NicolasNobili/MARK-1/README.md

# MARK I

## Multi Angle Radar Kinematics Mk. 1

# [Interfaz](https://nicolasnobili.github.io/MARK-1/)

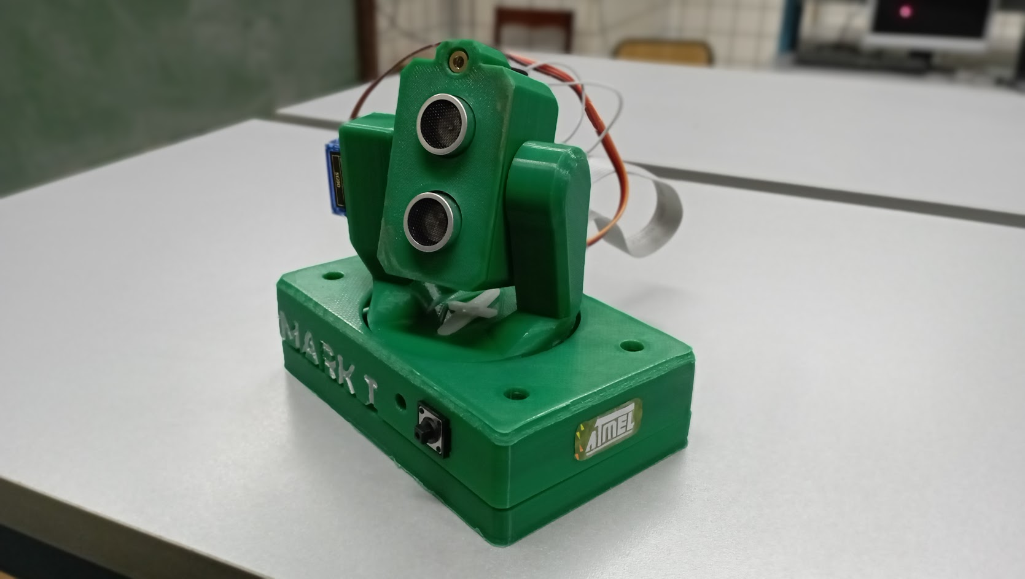
[picture p1: foto.png]
Foto
#
