NicolasNobili/MARK-1/markinforme/flujo.drawio.png

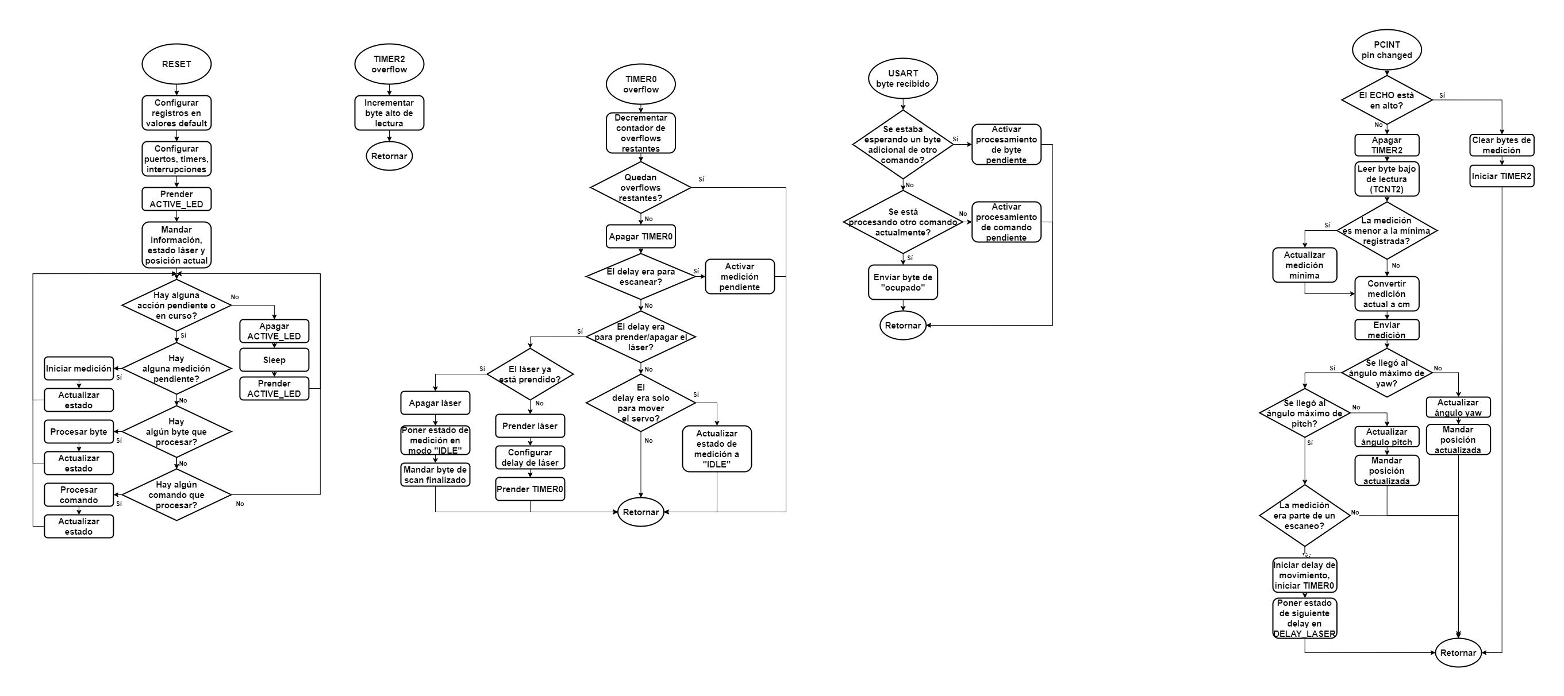
markinforme/flujo.drawio.png
