NicolasNobili/MARK-1/markinforme/flujo_timer2.png

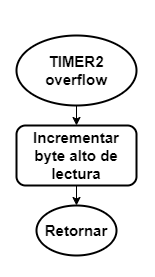
markinforme/flujo_timer2.png
