NicolasNobili/MARK-1/markmodel/3d_models/608rs-skate-bearing (1)/Renderings/608RS20111010-29232-tabqn5.JPG

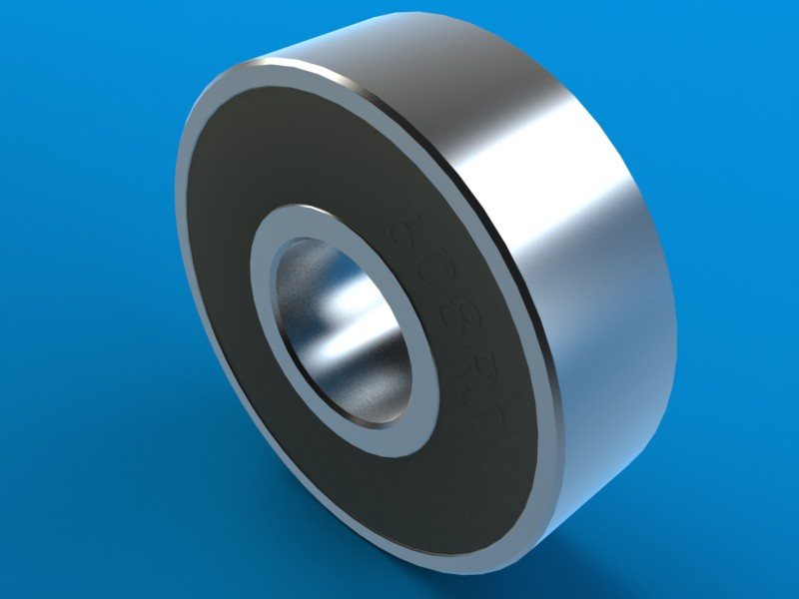
markmodel/3d_models/608rs-skate-bearing (1)/Renderings/608RS20111010-29232-tabqn5.JPG
