NicolasNobili/MARK-1/markmodel/3d_models/608rs-skate-bearing (1)/608RS.SLDPRT

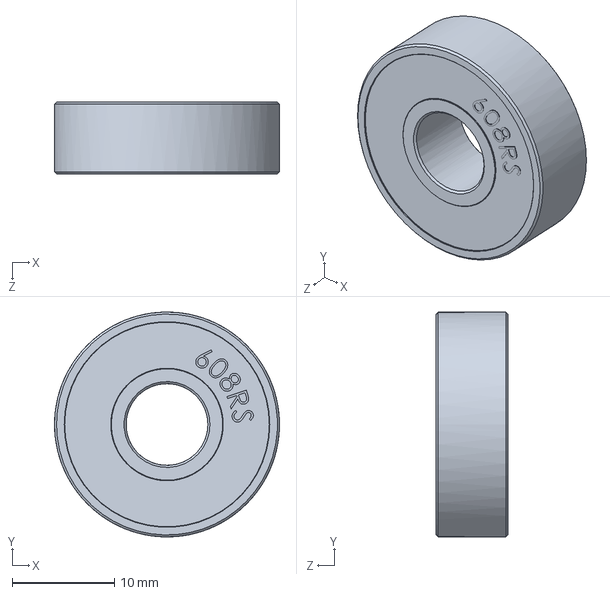
[picture p18: CAD file, 2023-11-22]
markmodel/3d_models/608rs-skate-bearing (1)/608RS.SLDPRT
22.0 x 22.0 x 7.00 mm
