NicolasNobili/MARK-1/markmodel/3d_models/DC_Power_Jack_PCB_Mounted_2.1mm.step

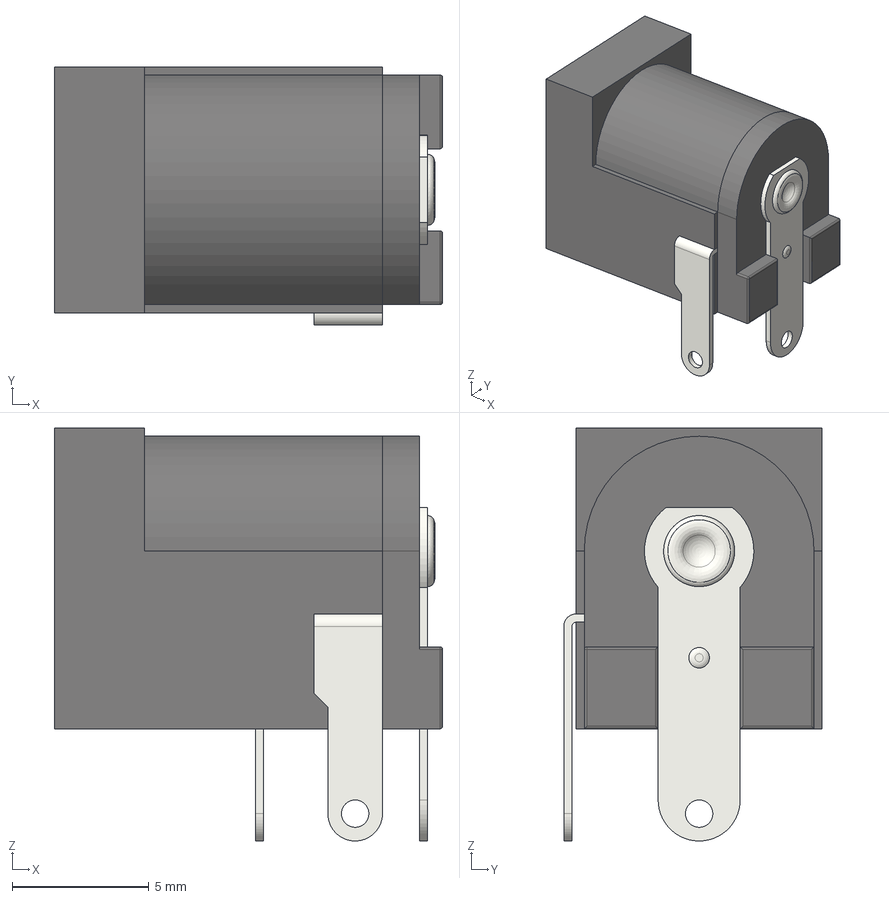
[picture p19: CAD file, 2023-11-27]
markmodel/3d_models/DC_Power_Jack_PCB_Mounted_2.1mm.step
14.2 x 9.45 x 15.1 mm
Plastic_Body_1of2
Plastic_Body_2of2
PIN_01
PIN_03
PIN_02
Boner
