NicolasNobili/MARK-1/markmodel/3d_models/hc-sr04-ultrasonic-sensor-8.snapshot.15/hc-sr04.SLDPRT

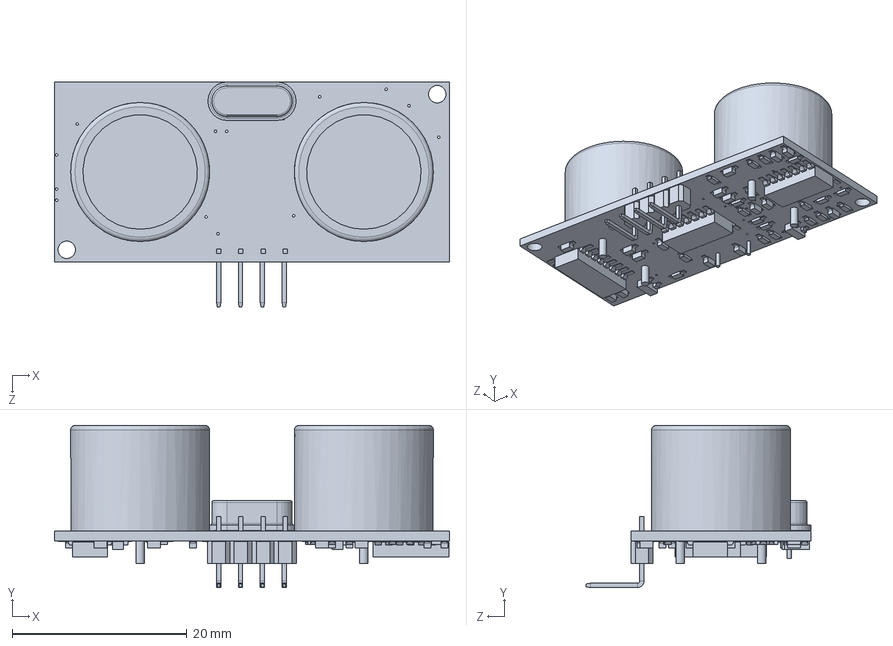
[picture p20: CAD file, 2023-11-12]
markmodel/3d_models/hc-sr04-ultrasonic-sensor-8.snapshot.15/hc-sr04.SLDPRT
45.2 x 18.5 x 25.8 mm
