NicolasNobili/MARK-1/markmodel/3d_models/sg90-micro-servo-9g-tower-pro-1.snapshot.3/SG90 - Micro Servo 9g - Tower Pro.2.SLDPRT

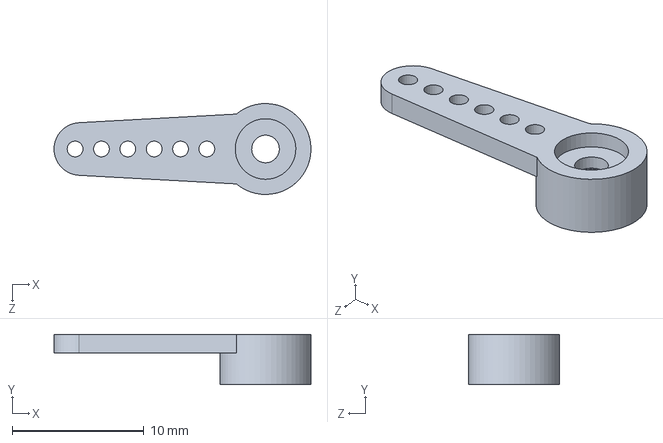
[picture p21: CAD file, 2023-11-22]
markmodel/3d_models/sg90-micro-servo-9g-tower-pro-1.snapshot.3/SG90 - Micro Servo 9g - Tower Pro.2.SLDPRT
19.5 x 3.80 x 6.90 mm
