NicolasNobili/MARK-1/markmodel/cutemark.FCStd

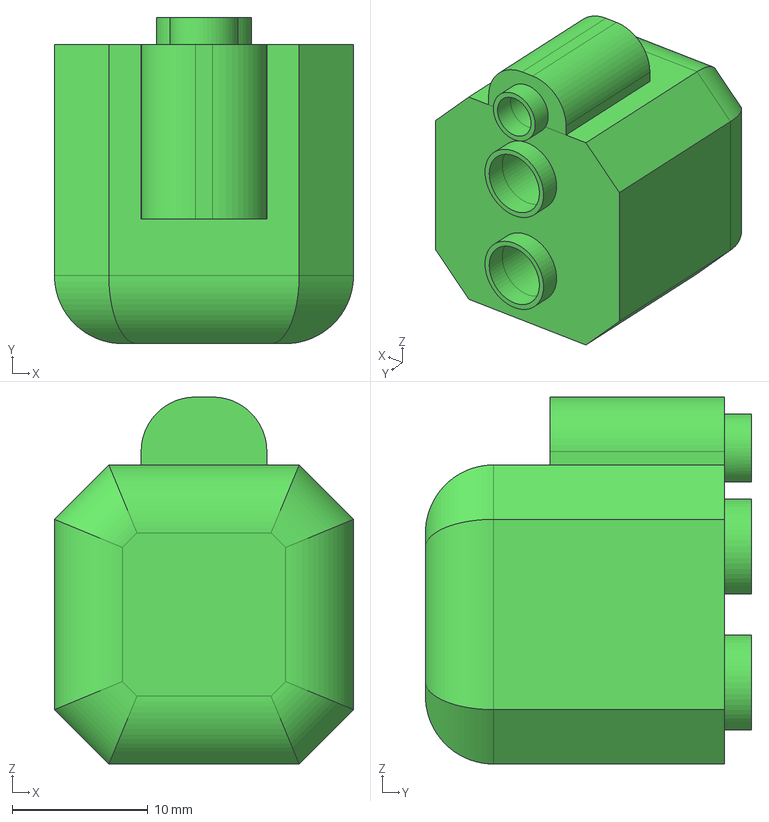
[picture p22: CAD file, 2023-12-03]
markmodel/cutemark.FCStd
22.0 x 24.0 x 27.0 mm
