NicolasNobili/MARK-1/markmodel/stl_files/gabinete_top-v3.stl

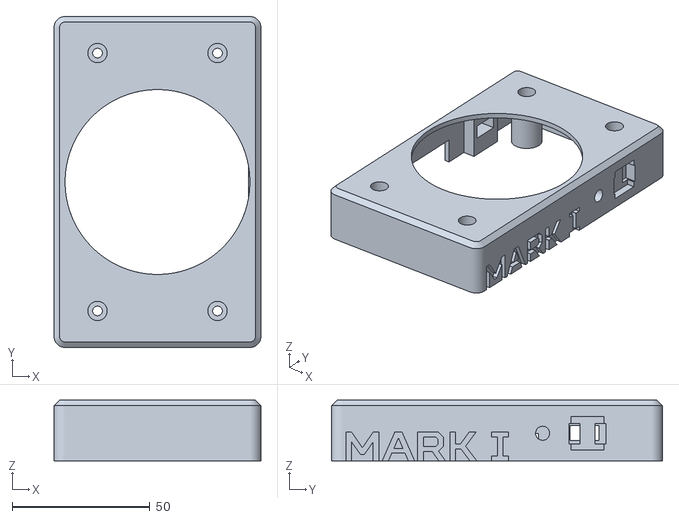
[picture p23: CAD file, 2023-12-02]
markmodel/stl_files/gabinete_top-v3.stl
75.0 x 120.0 x 22.0
