NicolasNobili/MARK-1/markmodel/3d_models/sg90-micro-servo-9g-tower-pro-1.snapshot.3/SG90 - Micro Servo 9g - Tower Pro.6.SLDPRT

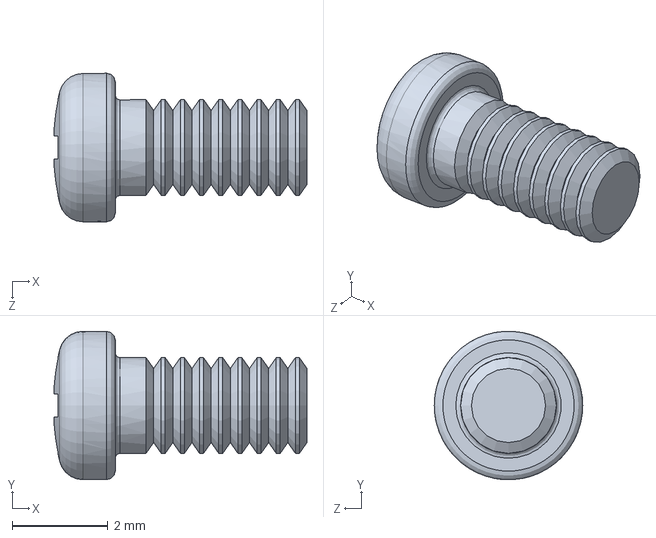
[picture p24: CAD file, 2023-11-22]
markmodel/3d_models/sg90-micro-servo-9g-tower-pro-1.snapshot.3/SG90 - Micro Servo 9g - Tower Pro.6.SLDPRT
5.28 x 3.10 x 3.10 mm
