NicolasNobili/MARK-1/markmodel/3d_models/ToggleSwitch_3Pin.step

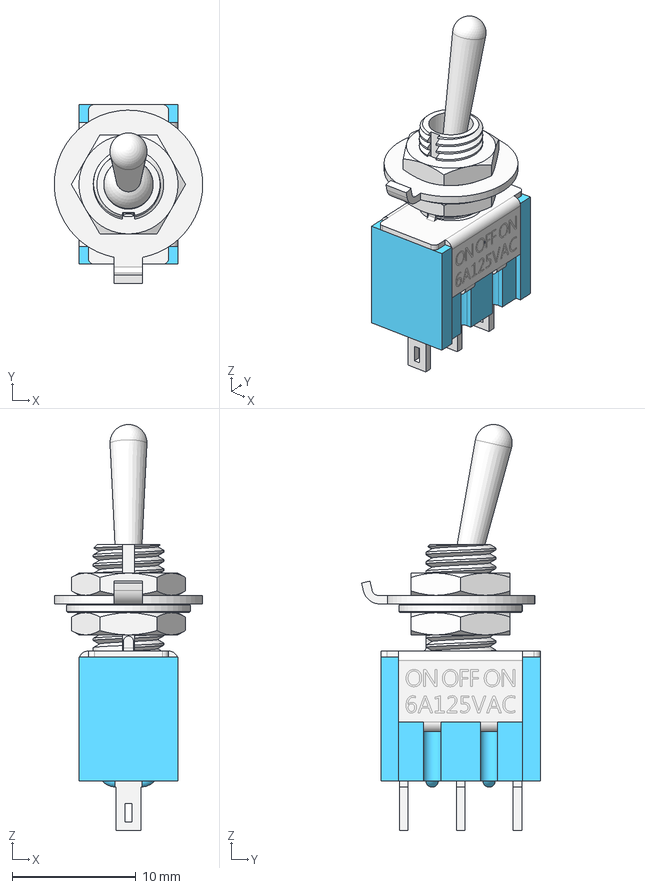
[picture p25: CAD file, 2023-11-26]
markmodel/3d_models/ToggleSwitch_3Pin.step
12.0 x 14.4 x 32.8 mm
Washer Anti Twist Protection
Nut M6x0.75mm
Nut M6x0.75mm clone
Sheetmatal Frame
Plastic Body
Thread
Batton Clone 1
PIN_1of3
PIN_2of3
PIN_3of3
Washer
