NicolasNobili/MARK-1/markmodel/encastre-servo.FCStd

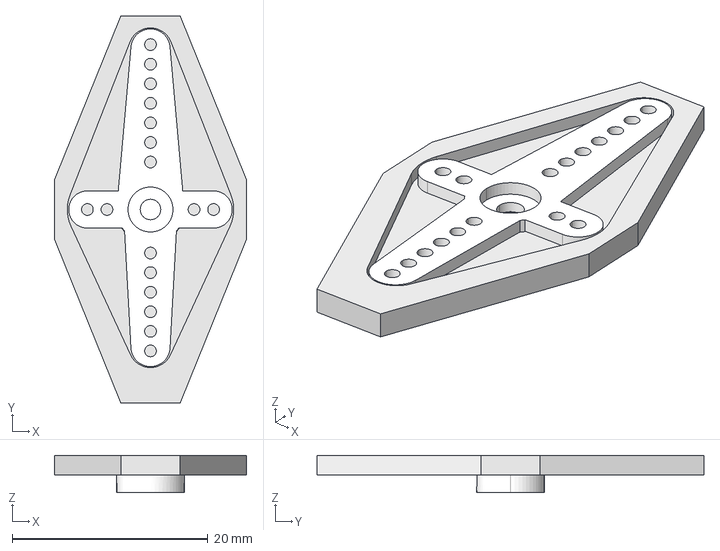
[picture p26: CAD file, 2023-11-25]
markmodel/encastre-servo.FCStd
19.7 x 39.5 x 3.80 mm
SG90 - Micro Servo 9g - Tower Pro.4_Pea
