NicolasNobili/MARK-1/markmodel/stl_files/gabinete_bottom-v2.stl

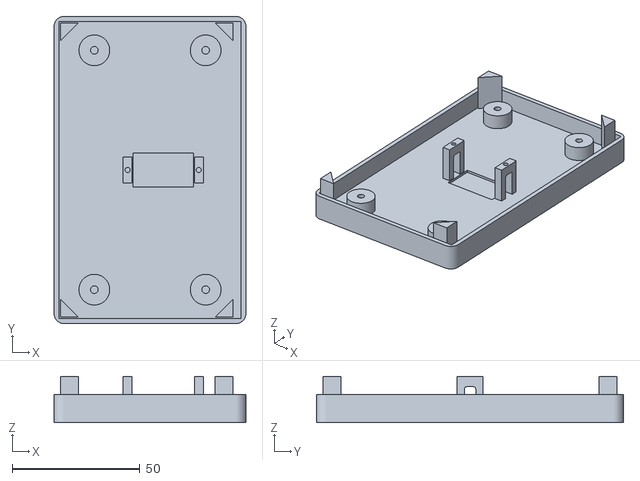
[picture p27: CAD file, 2023-11-30]
markmodel/stl_files/gabinete_bottom-v2.stl
75.0 x 120.0 x 18.0
