NicolasNobili/MARK-1/markmodel/3d_models/HC-06_Bluetooth_Module.step

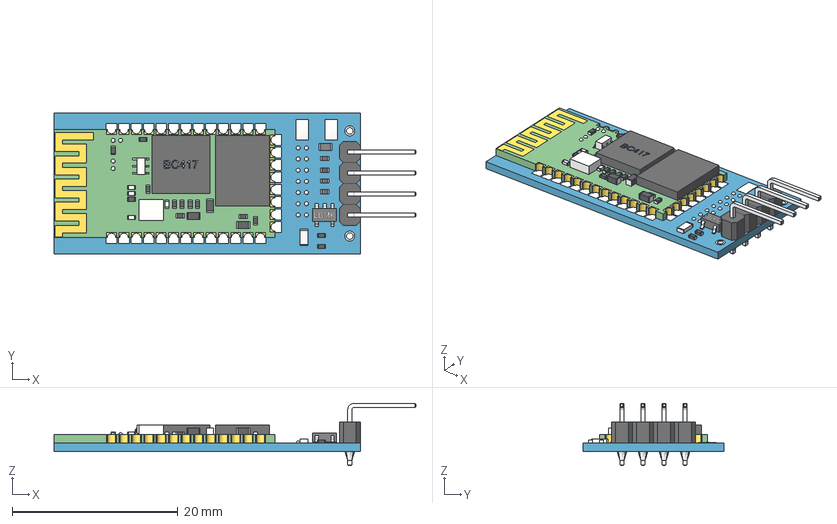
[picture p28: CAD file, 2023-11-23]
markmodel/3d_models/HC-06_Bluetooth_Module.step
43.7 x 17.0 x 7.52 mm
board
SPP-C_Bluetooth_Module
BC417
mx
small1005_smd_capacitor x 10
smd_capacitor x 3
small1005_smd_resistor
small_smd_led x 4
16MHz_Resonator_1
SOP-6
solder_dot_round_small x 4
smd_led
smd1005_smd_capacitor x 3
5V_regulator
solder_dot_round_small (1) x 14
solder_rectangle x 2
smd1005_resistor x 3
smd1608_resistor
pin_header_90_degree_bend x 4
solder x 4
