NicolasNobili/MARK-1/markmodel/columna_servo.FCStd

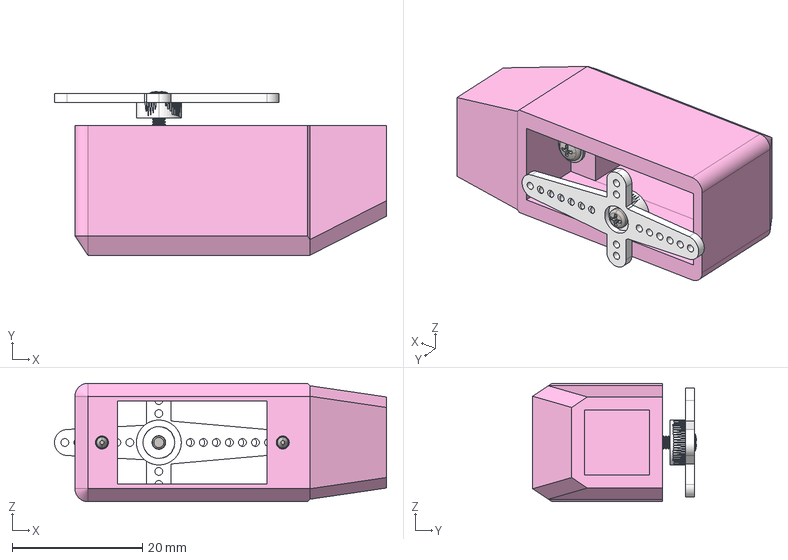
[picture p29: CAD file, 2023-11-23]
markmodel/columna_servo.FCStd
51.0 x 25.2 x 18.2 mm
columna_servo
SG90 - Micro Servo 9g - Tower Pro.2_Pea
SG90 - Micro Servo 9g - Tower Pro.3_Pea
SG90 - Micro Servo 9g - Tower Pro.4_Pea
SG90 - Micro Servo 9g - Tower Pro.5_BS EN ISO 7045 - M2 x 8 - Z - 8S
SG90 - Micro Servo 9g - Tower Pro.5_BS EN ISO 7045 - M2 x 8 - Z - 8S001
SG90 - Micro Servo 9g - Tower Pro.6_BS EN ISO 7045 - M2 x 4 - Z - 4S
