NicolasNobili/MARK-1/markmodel/stl_files/mark_tapa-v6.stl

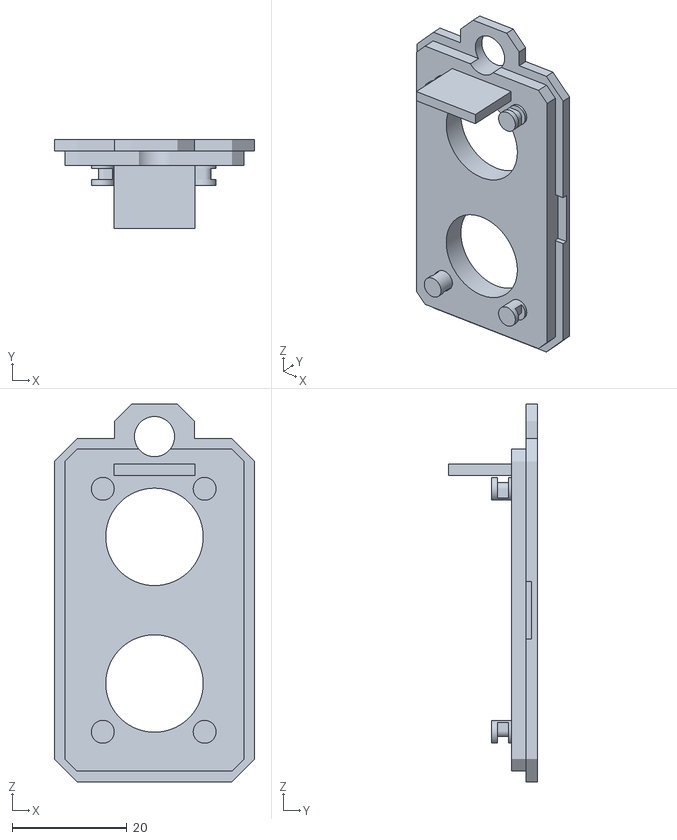
[picture p30: CAD file, 2023-11-30]
markmodel/stl_files/mark_tapa-v6.stl
35.0 x 15.5 x 66.0
