NicolasNobili/MARK-1/markmodel/3d_models/LaserModule.stp

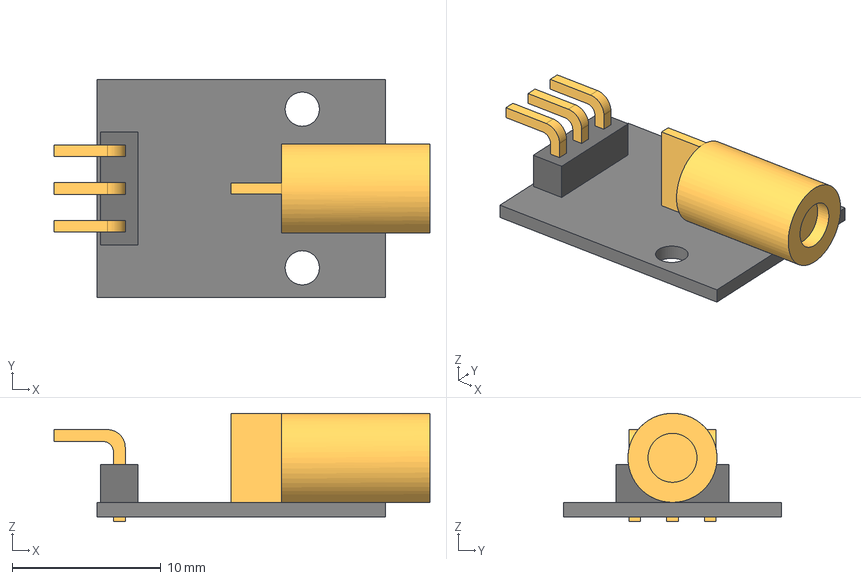
[picture p31: CAD file, 2023-11-13]
markmodel/3d_models/LaserModule.stp
25.3 x 14.7 x 7.30 mm
