NicolasNobili/MARK-1/markmodel/columna_ruleman.FCStd

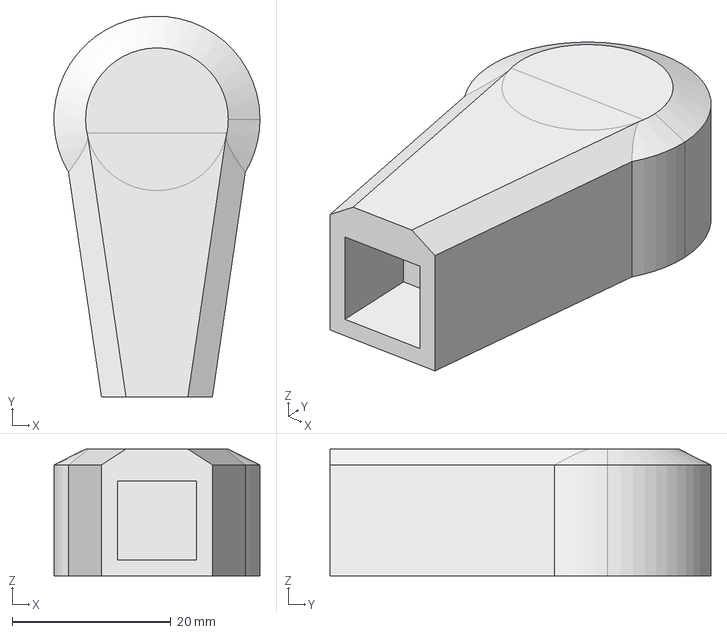
[picture p33: CAD file, 2023-11-23]
markmodel/columna_ruleman.FCStd
26.0 x 48.0 x 16.0 mm
