NicolasNobili/MARK-1/markmodel/mark3D.FCStd

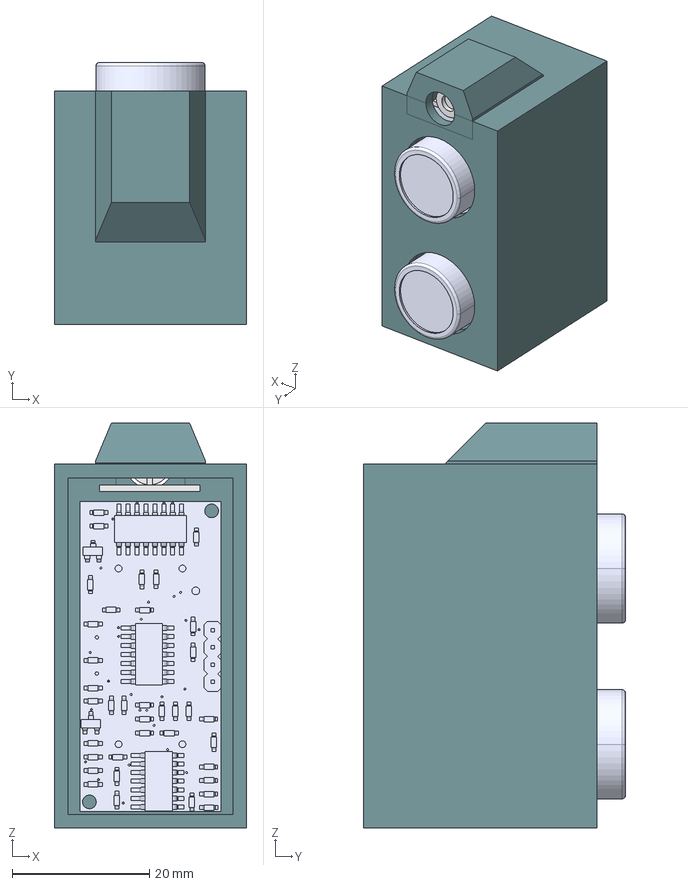
[picture p35: CAD file, 2023-11-14]
markmodel/mark3D.FCStd
28.0 x 38.2 x 59.0 mm
HC-SR04
Laser (truncado)
