NicolasNobili/MARK-1/markmodel/mark3D-gabinete-borrador1.stl

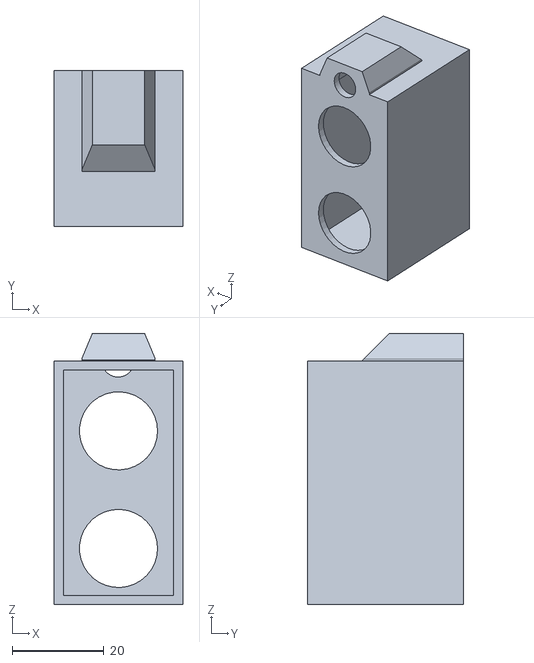
[picture p37: CAD file, 2023-11-14]
markmodel/mark3D-gabinete-borrador1.stl
28.0 x 34.0 x 59.0
