NicolasNobili/MARK-1/markmodel/stl_files/base_rotativa-v3.stl

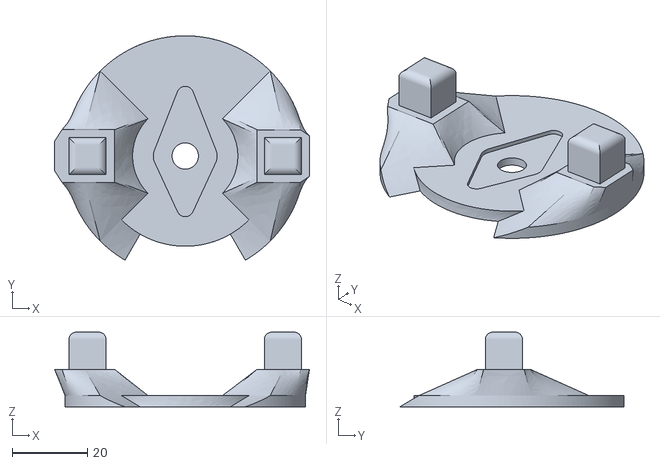
[picture p39: CAD file, 2023-11-24]
markmodel/stl_files/base_rotativa-v3.stl
67.9 x 59.7 x 19.9
