NicolasNobili/MARK-1/markmodel/stl_files/encastre_servo-v1.stl

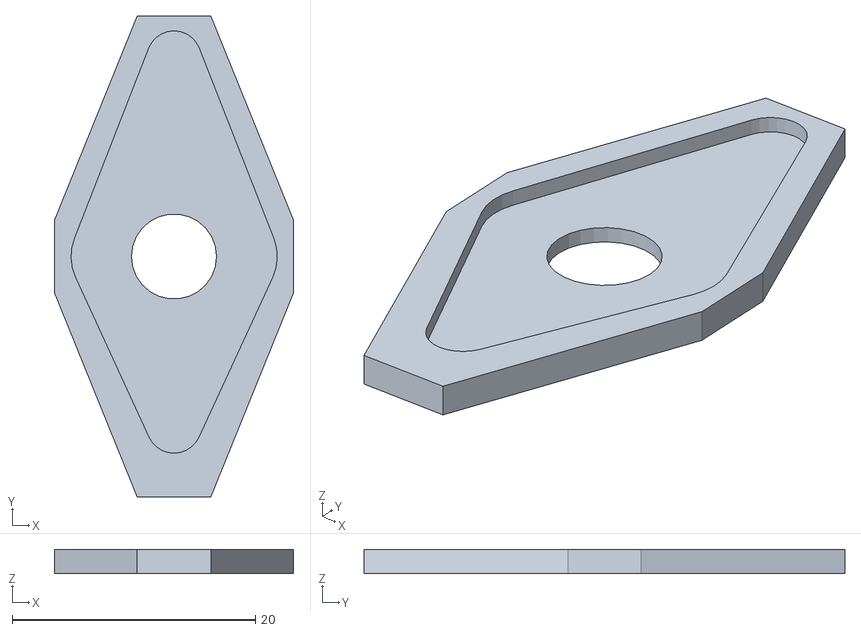
[picture p40: CAD file, 2023-11-24]
markmodel/stl_files/encastre_servo-v1.stl
19.7 x 39.5 x 2.00
