NicolasNobili/MARK-1/markmodel/stl_files/columna_servo-v2.stl

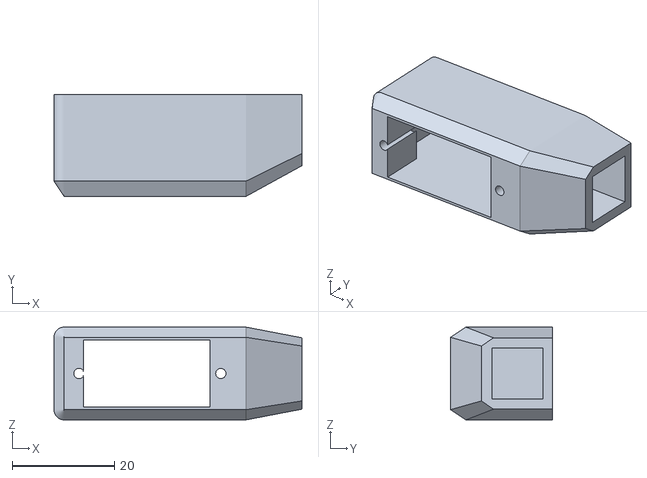
[picture p41: CAD file, 2023-11-24]
markmodel/stl_files/columna_servo-v2.stl
48.6 x 20.0 x 18.2
