NicolasNobili/MARK-1/markmodel/stl_files/mark_body-v1.stl

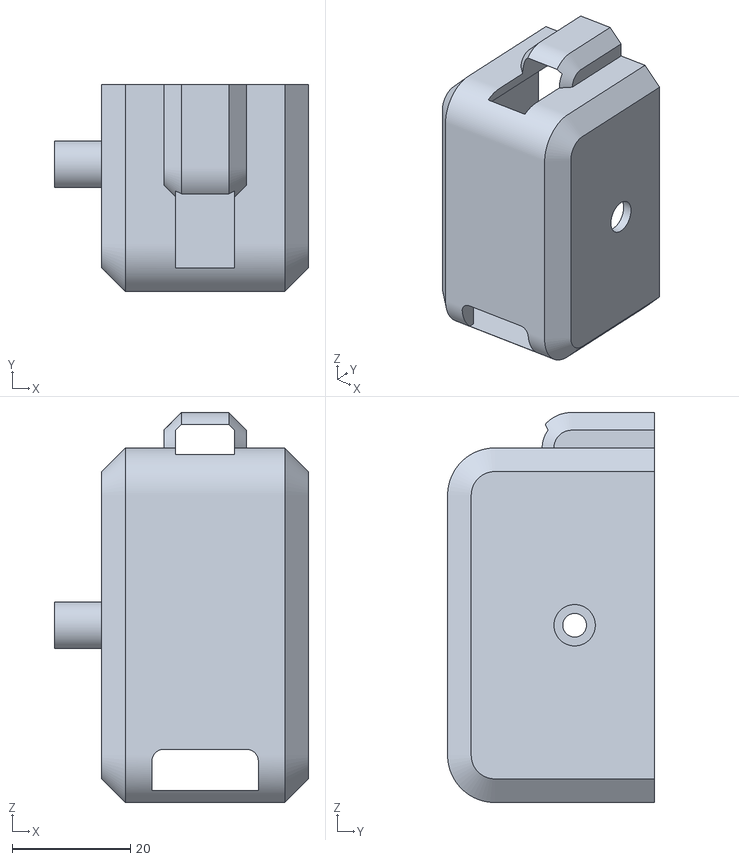
[picture p42: CAD file, 2023-11-24]
markmodel/stl_files/mark_body-v1.stl
43.0 x 35.0 x 66.0
