NicolasNobili/MARK-1/(list of files, cad)

Other CAD files:
markmodel/stl_files/columna_ruleman-v1.stl
markmodel/3d_models/608rs-skate-bearing (1)/608RS.stl
markmodel/3d_models/sg90-micro-servo-9g-tower-pro-1.snapshot.3/SG90 - Micro Servo 9g - Tower Pro.x_t
markmodel/stl_files/base_rotativa-v1.stl
markmodel/stl_files/base_rotativa-v2.stl
markmodel/stl_files/columna_servo-v1.stl
markmodel/stl_files/gabinete_bottom-v1.stl
markmodel/stl_files/gabinete_top-v1.stl
markmodel/stl_files/gabinete_top-v2.stl
markmodel/stl_files/mark_tapa-v1.stl
markmodel/stl_files/mark_tapa-v3.stl
markmodel/stl_files/mark_tapa-v4.stl
markmodel/stl_files/mark_tapa-v5.stl
