NicolasNobili/MARK-1/markmodel/markcircuit/schematic.pdf

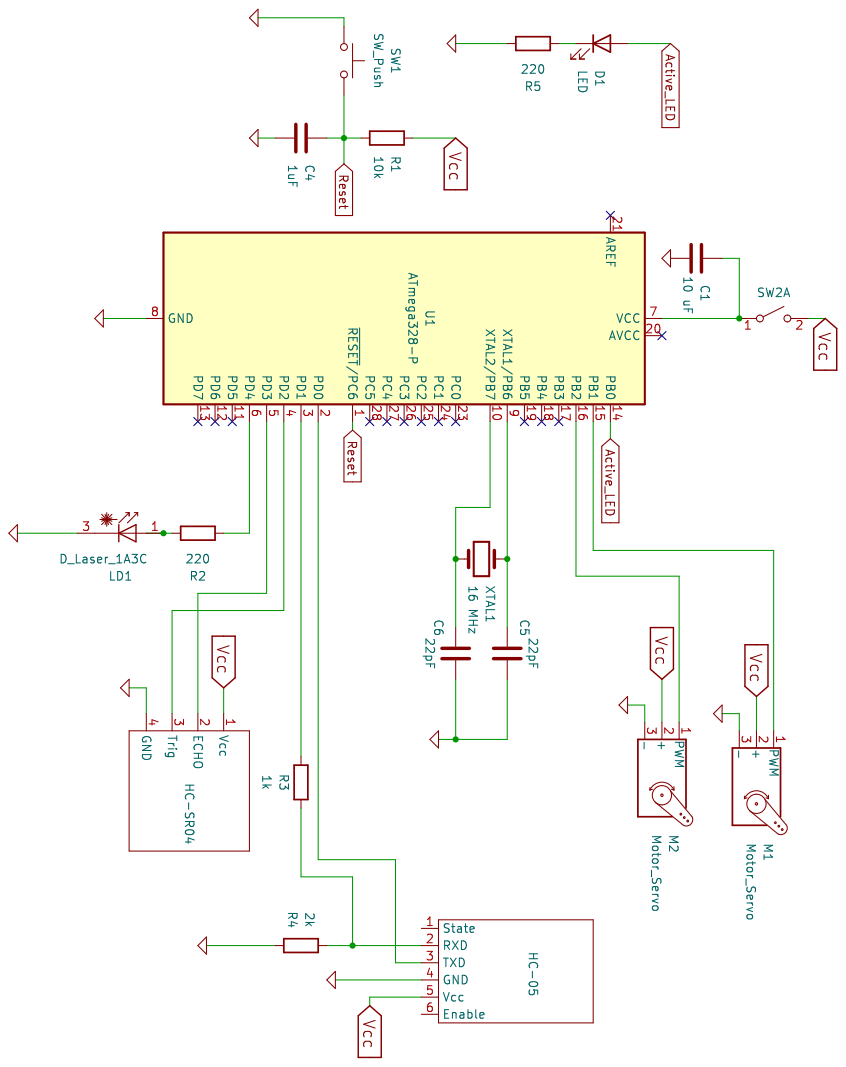
[picture p43: page 1]
