NicolasNobili/MARK-1/(list of files, drawings)

Other design files:
TI_Nobili_Russo_proteus.pdsprj
