NicolasNobili/MARK-1/markmodel/markcircuit/markcircuit.kicad_pcb

## KiCad design schmatic/schmatic.kicad_sch

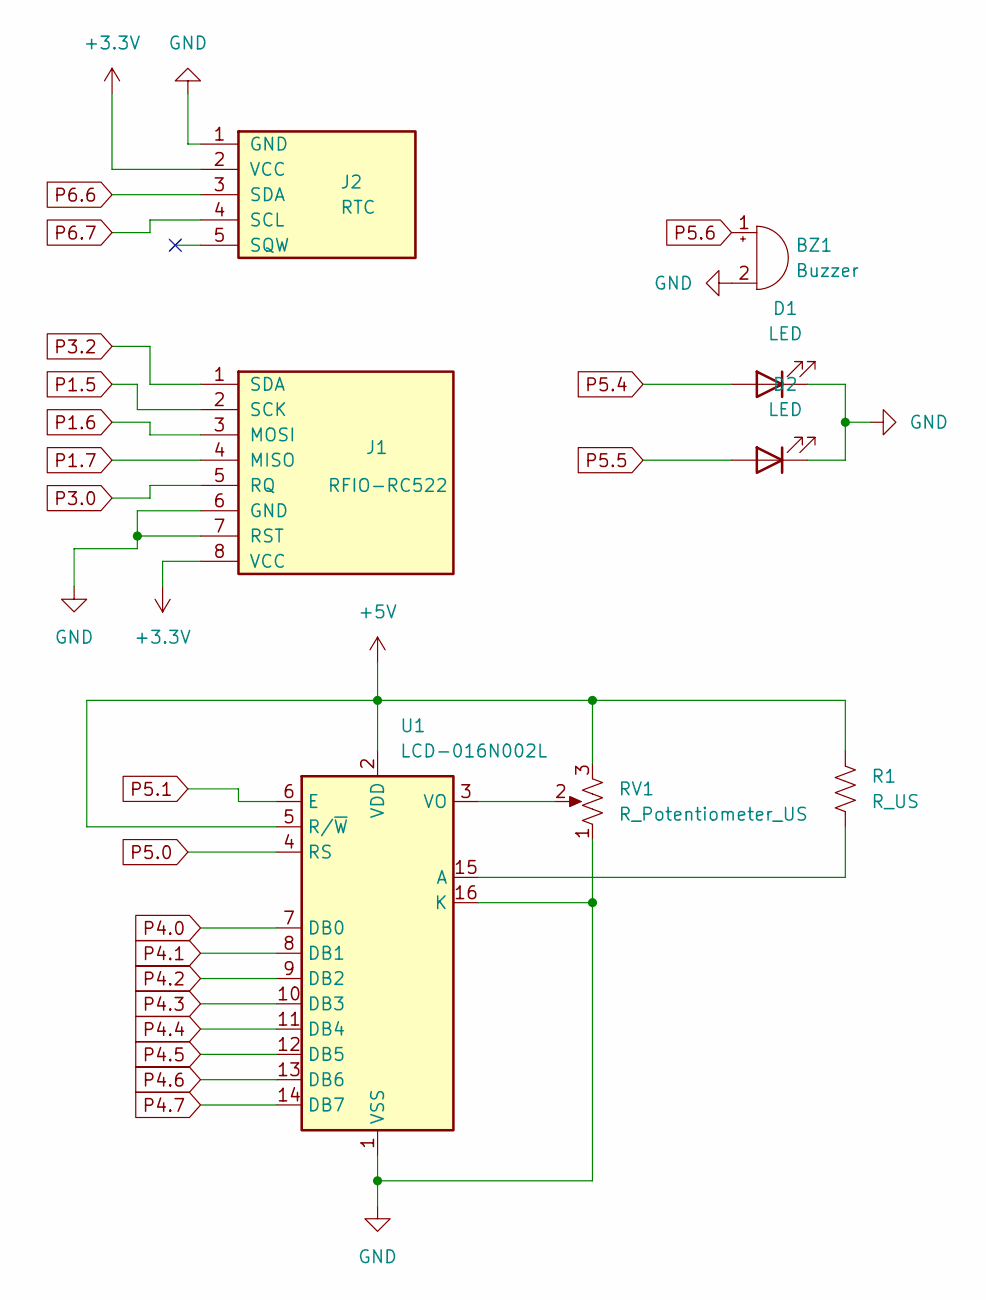
[picture p44: schematic schmatic.kicad_sch]

Parts:
BZ1: Buzzer
D1, D2: LED
J1: RFIO-RC522
J2: RTC
R1: R_US
RV1: R_Potentiometer_US
U1: LCD-016N002L

Connections:
+3.3V: J1.8 (VCC), J2.2 (VCC)
+5V: R1.1, RV1.3, U1.2 (VDD), U1.5 (R/~W)
GND: BZ1.2 (-), D1.1 (K), D2.1 (K), J1.6 (GND), J1.7 (RST), J2.1 (GND), RV1.1, U1.1 (VSS), U1.16 (K)
unnamed: R1.2, U1.15 (A)
unnamed: RV1.2, U1.3 (VO)
P1.5: J1.2 (SCK)
P1.6: J1.3 (MOSI)
P1.7: J1.4 (MISO)
P3.0: J1.5 (RQ)
P3.2: J1.1 (SDA)
P4.0: U1.7 (DB0)
P4.1: U1.8 (DB1)
P4.2: U1.9 (DB2)
P4.3: U1.10 (DB3)
P4.4: U1.11 (DB4)
P4.5: U1.12 (DB5)
P4.6: U1.13 (DB6)
P4.7: U1.14 (DB7)
P5.0: U1.4 (RS)
P5.1: U1.6 (E)
P5.4: D1.2 (A)
P5.5: D2.2 (A)
P5.6: BZ1.1 (+)
P6.6: J2.3 (SDA)
P6.7: J2.4 (SCL)
