NicolasNobili/MARK-1/(commit log)

2023-11-11 Nace MARK-1
    [usart_prueba.pdsprj]
2023-11-11 elimino archvios basura
    [usart_prueba.pdsprj]
2023-11-12 carriage return new line
2023-11-12 problemas al medir
    [MARK1_proteus.pdsprj]
2023-11-12 pudimos medir algo
    [MARK1_proteus.pdsprj]
2023-11-12 modelado 3d y circuito
    [MARK1_proteus.pdsprj, hc-sr04.SLDPRT, mark3D.FCStd, markcircuit.kicad_pcb, markcircuit.kicad_sch]
2023-11-13 reorganizacion de codigo
2023-11-13 disenio 3D basico
    [LaserModule.stp, MARK1_proteus.pdsprj, mark3D.FCStd]
2023-11-14 power down
2023-11-14 active led
2023-11-15 mark beta
    [MARK1_proteus.pdsprj]
2023-11-15 sleep + reset + change position fixed
    [MARK1_config.asm, MARK1_handlers.asm, MARK1_include.asm, main.asm]
2023-11-22 3d model
    [608RS.SLDPRT, 608RS.stl, MARK1_proteus.pdsprj, SG90 - Micro Servo 9g - Tower Pro.1.SLDPRT, SG90 - Micro Servo 9g - Tower Pro.2.SLDPRT, SG90 - Micro Servo 9g - Tower Pro.3.SLDPRT, SG90 - Micro Servo 9g - Tower Pro.4.SLDPRT, SG90 - Micro Servo 9g - Tower Pro.5.SLDPRT]
2023-11-22 encastre ruleman
    [columna_ruleman.FCStd]
2023-11-22 update tamaño ruleman
    [columna_ruleman.FCStd]
2023-11-22 columna servo (sin medidas)
    [columna_servo.FCStd]
2023-11-23 parte ruleman terminado (?)
    [columna_ruleman.FCStd]
2023-11-23 modelo stl ruleman
    [columna_ruleman-Body001.stl, columna_ruleman.FCStd]
2023-11-23 columnas ruleman servo stls
    [columna_ruleman-Body001.stl, columna_ruleman-v1.stl, columna_ruleman.FCStd, columna_servo-v1.stl, columna_servo.FCStd]
2023-11-23 todo en el archivo MARK3D
    [HC-06_Bluetooth_Module.step, columna_ruleman.FCStd, columna_servo.FCStd]
2023-11-24 details 3D model
    [columna_ruleman-v1 - Copy.stl]
2023-11-24 stl folder
    [base_rotativa-v1.stl, columna_ruleman-v1 - Copy.stl, columna_ruleman-v1.stl, columna_servo-v1.stl, columna_servo.stl, mark_body-v1.stl, mark_tapa-v1.stl]
2023-11-24 versiones nuevas
    [mark_tapa-v3.stl]
2023-11-25 qierido mark
    [encastre-servo.FCStd]
2023-11-25 Schematic + symbols
    [markcircuit.kicad_sch]
2023-11-26 gabinete BIEN HECHO
    [markcircuit.kicad_sch]
2023-11-26 tapa v4, columna servo v3
    [mark_tapa-v4.stl]
2023-11-26 no se que agregue en este
2023-11-26 correcion columna servo v4
2023-11-27 tapa v5
    [mark_tapa-v5.stl]
2023-11-27 gabinete bottom v1
    [gabinete_bottom-v1.stl]
2023-11-27 texto, huecos LED, hueco BUTTON, hueco JACK
    [DC_Power_Jack_PCB_Mounted_2.1mm.step]
2023-11-27 todo listo (anulo mufa)
    [gabinete_top-v1.stl]
2023-11-29 pin changes
    [MARK1_proteus.pdsprj]
2023-11-29 tapa V6
    [mark_tapa-v6.stl]
2023-11-30 parte bottom pro
    [gabinete_bottom-v2.stl]
2023-12-02 top nuevo
    [gabinete_top-v3.stl]
2023-12-06 diagrama de flujos incompleto
2023-12-08 proteus changes
    [MARK1_proteus.pdsprj]
2023-12-08 commit final
    [TI_Nobili_Russo_proteus.pdsprj]
